retrospy/Music_Board/Newtech Music Board.brd

## EAGLE design Newtech Music Board.brd (2024-07-18)

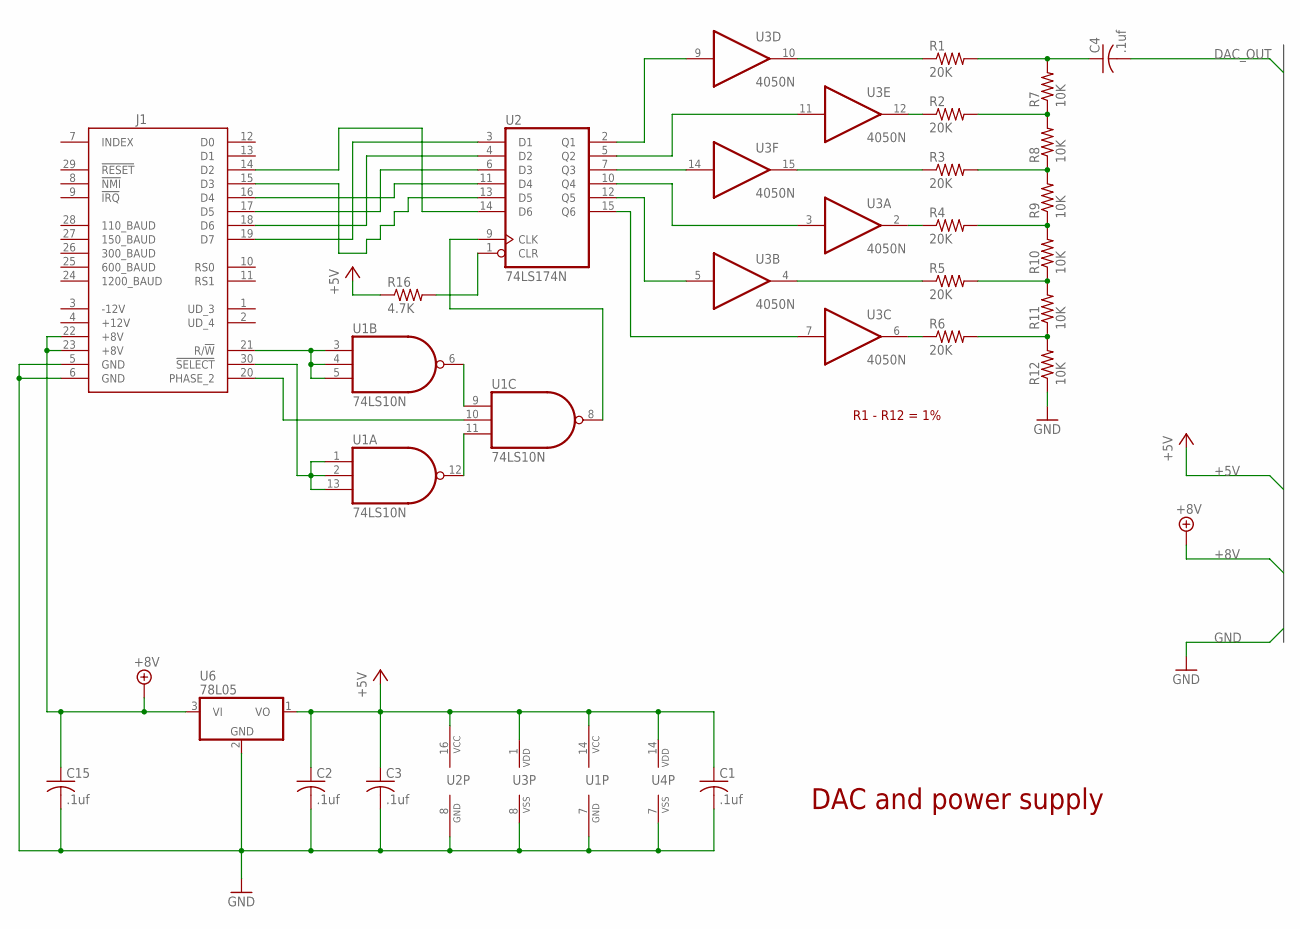
[picture p1: schematic Newtech Music Board.sch, sheet 1]

Parts:
C1, C2, C3, C15: .1uf; C025-025X050
C4: .1uf; C025-024X044
J1: SS-30_BOARD_CONNECTOR
R1, R2, R3, R4, R5, R6: 20K; 0204/7
R7, R8, R9, R10, R11, R12: 10K; 0204/7
R16: 4.7K; 0204/7
U1: 74LS10N; DIL14
U2: 74LS174N; DIL16
U3: 4050N; DIL16
U4: 4069N; DIL14
U6: 78L05; TO-92

Connections:
!SELECT: J1.30 (!SELECT), U1.1 (I0), U1.2 (I1), U1.13 (I2)
+5V: C1.1, C2.1, C3.1, R16.1, U1.14 (VCC), U2.16 (VCC), U3.1 (VDD), U4.14 (VDD), U6.1 (VO)
+8V: C15.1, J1.22 (+8V), J1.23 (+8V), U6.3 (VI); also elsewhere on the board
+12V: J1.4 (+12V)
-12V: J1.3 (-12V)
DAC_OUT: C4.2; also elsewhere on the board
GND: C1.2, C2.2, C3.2, C15.2, J1.5 (GND), J1.6 (GND), R12.1, U1.7 (GND), U2.8 (GND), U3.8 (VSS), U4.7 (VSS), U6.2 (GND); also elsewhere on the board
unnamed: J1.19 (D7), U2.3 (D1)
unnamed: J1.18 (D6), U2.4 (D2)
unnamed: J1.17 (D5), U2.6 (D3)
unnamed: U1.6 (O), U1.9 (I0)
unnamed: U1.11 (I2), U1.12 (O)
unnamed: J1.16 (D4), U2.11 (D4)
unnamed: J1.15 (D3), U2.13 (D5)
unnamed: J1.14 (D2), U2.14 (D6)
unnamed: U2.2 (Q1), U3.9 (I)
unnamed: U2.5 (Q2), U3.11 (I)
unnamed: U2.7 (Q3), U3.14 (I)
unnamed: U2.10 (Q4), U3.3 (I)
unnamed: U2.12 (Q5), U3.5 (I)
unnamed: U2.15 (Q6), U3.7 (I)
unnamed: U1.8 (O), U2.9 (CLK)
unnamed: R16.2, U2.1 (CLR)
unnamed: R1.1, U3.10 (O)
unnamed: R2.1, U3.12 (O)
unnamed: R3.1, U3.15 (O)
unnamed: R4.1, U3.2 (O)
unnamed: R5.1, U3.4 (O)
unnamed: R6.1, U3.6 (O)
unnamed: R2.2, R7.1, R8.2
unnamed: R3.2, R8.1, R9.2
unnamed: R4.2, R9.1, R10.2
unnamed: R5.2, R10.1, R11.2
unnamed: R6.2, R11.1, R12.2
unnamed: C4.1, R1.2, R7.2
PHASE2: J1.20 (PHASE_2), U1.10 (I1)
R/!W: J1.21 (R/!W), U1.3 (I0), U1.4 (I1), U1.5 (I2)

Notes on the sheet:
DAC and power supply
R1 - R12 = 1%

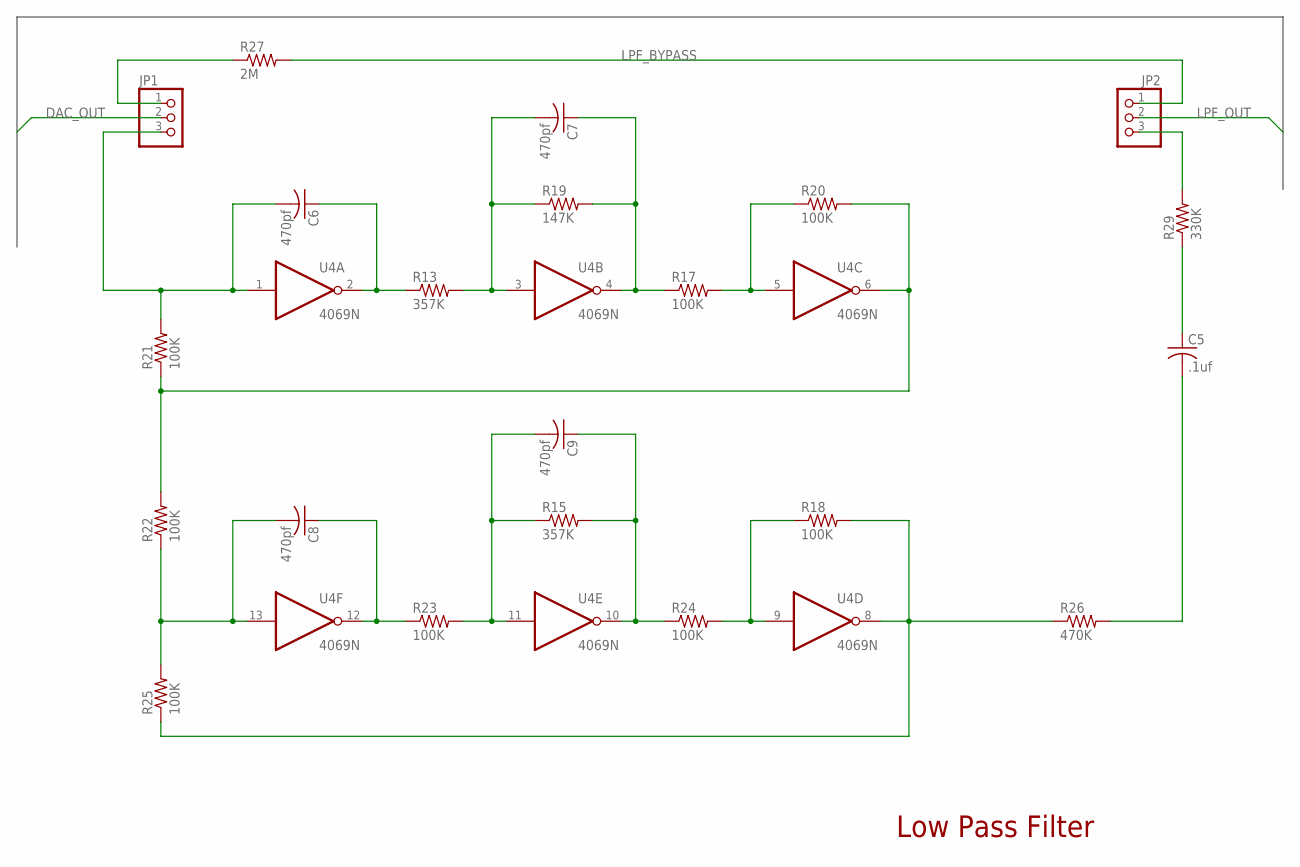
[picture p2: schematic Newtech Music Board.sch, sheet 2]

Parts:
C5: .1uf; C025-025X050
C6, C7, C8, C9: 470pf; C050-045X075
JP1, JP2: PINHD-1X3; 1X03
R13, R15: 357K; 0204/7
R17, R18, R20, R21, R22, R23, R24, R25: 100K; 0204/7
R19: 147K; 0204/7
R26: 470K; 0204/7
R27: 2M; 0204/7
R29: 330K; 0204/7
U4: 4069N; DIL14

Connections:
DAC_OUT: JP1.2; also elsewhere on the board
LPF_BYPASS: JP2.1, R27.2
LPF_OUT: JP2.2; also elsewhere on the board
unnamed: C6.2, JP1.3, R21.2, U4.1 (I)
unnamed: JP2.3, R29.2
unnamed: C6.1, R13.1, U4.2 (O)
unnamed: C7.2, R13.2, R19.1, U4.3 (I)
unnamed: C7.1, R17.1, R19.2, U4.4 (O)
unnamed: R17.2, R20.1, U4.5 (I)
unnamed: R20.2, R21.1, R22.2, U4.6 (O)
unnamed: JP1.1, R27.1
unnamed: C8.1, R23.1, U4.12 (O)
unnamed: C9.2, R15.1, R23.2, U4.11 (I)
unnamed: C9.1, R15.2, R24.1, U4.10 (O)
unnamed: R18.1, R24.2, U4.9 (I)
unnamed: R18.2, R25.1, R26.1, U4.8 (O)
unnamed: C5.2, R26.2
unnamed: C5.1, R29.1
unnamed: C8.2, R22.1, R25.2, U4.13 (I)

Notes on the sheet:
Low Pass Filter

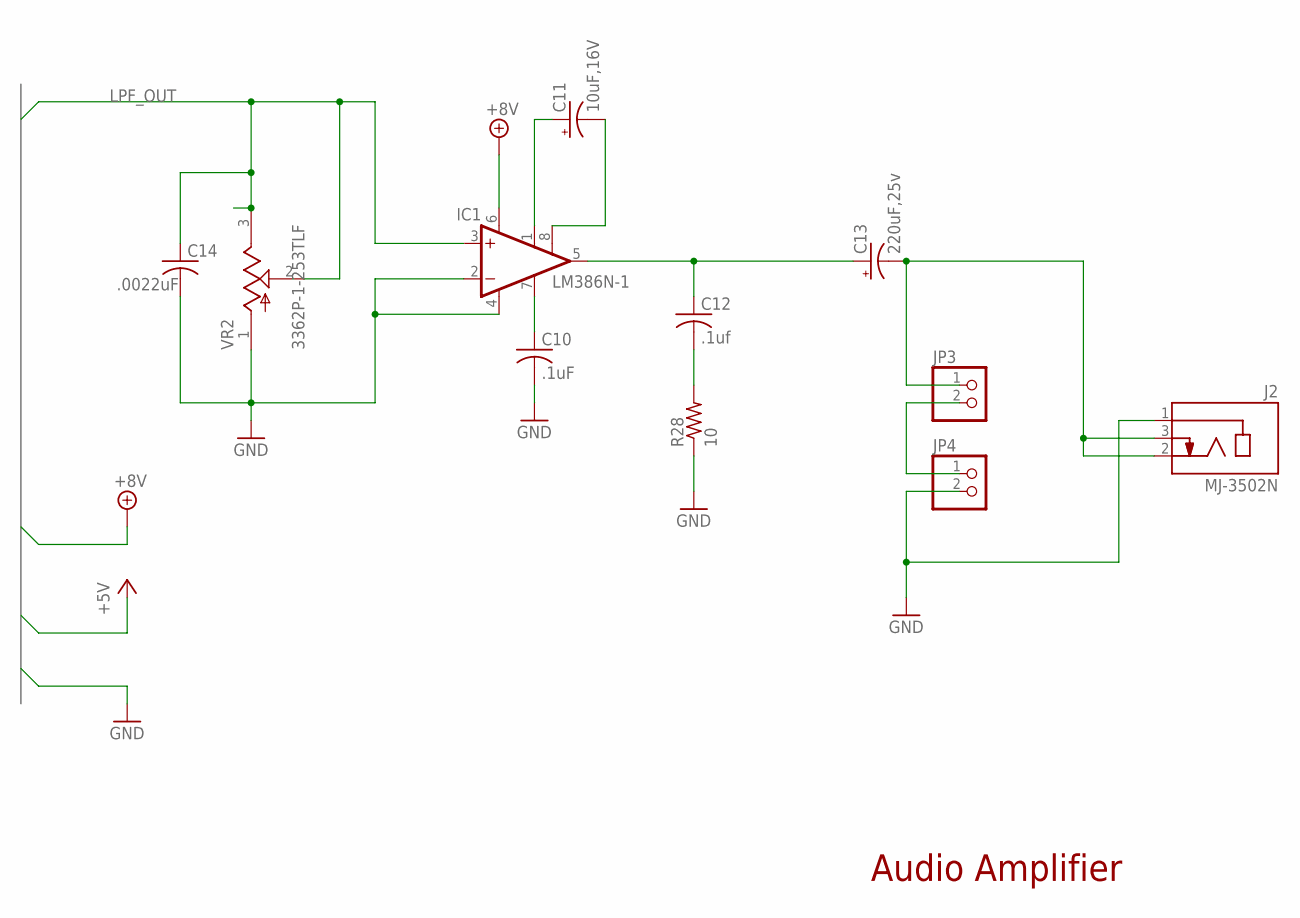
[picture p3: schematic Newtech Music Board.sch, sheet 3]

Parts:
C10: .1uF; C025-025X050
C11: 10uF,16V; E2,5-6
C12: .1uf; C025-025X050
C13: 220uF,25v; E25-9
C14: .0022uF; C025-025X050
IC1: LM386N-1; DIL08
J2: MJ-3502N; CUI_MJ-3502N
JP3, JP4: PINHD-1X2; 1X02
R28: 10; 0204/7
VR2: 3362P-1-253TLF; TRIM_3362P-1-253TLF

Connections:
+8V: IC1.6 (VS); also elsewhere on the board
GND: C10.2, C14.2, IC1.2 (-IN), IC1.4 (GND), J2.1, JP4.2, R28.1, VR2.1 (CCW); also elsewhere on the board
LPF_OUT: C14.1, IC1.3 (+IN), VR2.2 (WIPER), VR2.3 (CW); also elsewhere on the board
unnamed: JP3.2, JP4.1
unnamed: C10.1, IC1.7 (BYPASS)
unnamed: C12.2, R28.2
unnamed: C11.+, IC1.1 (GAIN)
unnamed: C12.1, C13.+, IC1.5 (OUT)
unnamed: C13.-, J2.2, J2.3, JP3.1
unnamed: C11.-, IC1.8 (GAIN)

Notes on the sheet:
Audio Amplifier

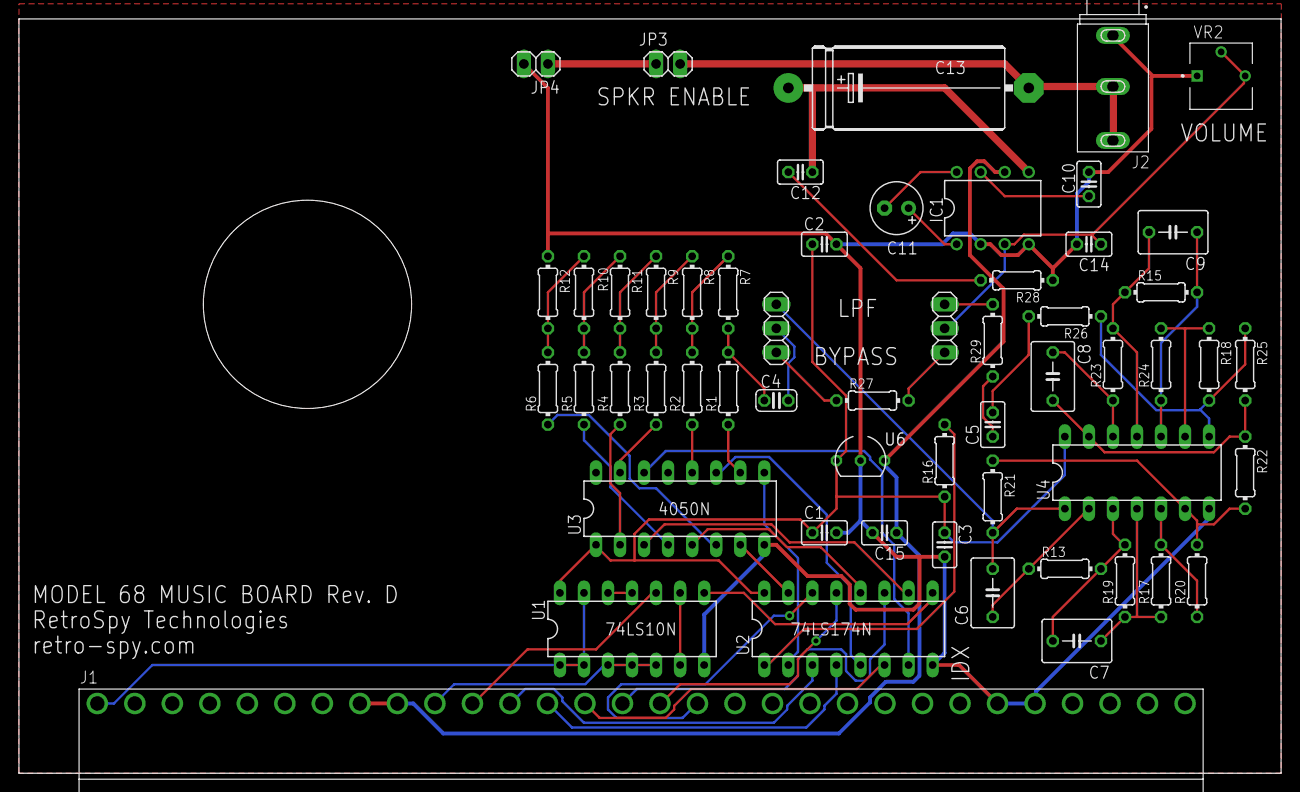
[picture p4: board Newtech Music Board.brd from above]

Board: 2 copper layers, 133.3 x 79.7 mm, 56 parts (0 on the bottom side), 60 nets.
