retrospy/Music_Board/(commit log)

2023-10-03 Updated Speaker and incorrect resistor value
    [Newtech Music Board.brd, Newtech Music Board.sch]
2023-10-10 Added headphone jack out
    [Newtech Music Board.brd, Newtech Music Board.sch]
2024-03-26 Put real speaker on
    [Newtech Music Board.brd, Newtech Music Board.sch]
2024-03-29 Matched the circuit to the S-100 Board
    [Newtech Music Board.brd, Newtech Music Board.sch]
2024-03-29 Put back the LM386
    [Newtech Music Board.brd, Newtech Music Board.sch]
2024-04-03 Modifcations for prototype
    [Newtech Music Board.brd, Newtech Music Board.sch]
2024-07-10 Redid the DAC routing
    [Newtech Music Board.brd, Newtech Music Board.sch]
2024-07-17 Rearranged ICs to try and fix stuttering
    [Newtech Music Board.brd]
2024-07-18 Fixed the mixed up D7 and D5 lines
    [Newtech Music Board.brd, Newtech Music Board.sch]
